Albedorox/smart-shisha-led/cad/v6/ansicht_schnitt_aussenring.png

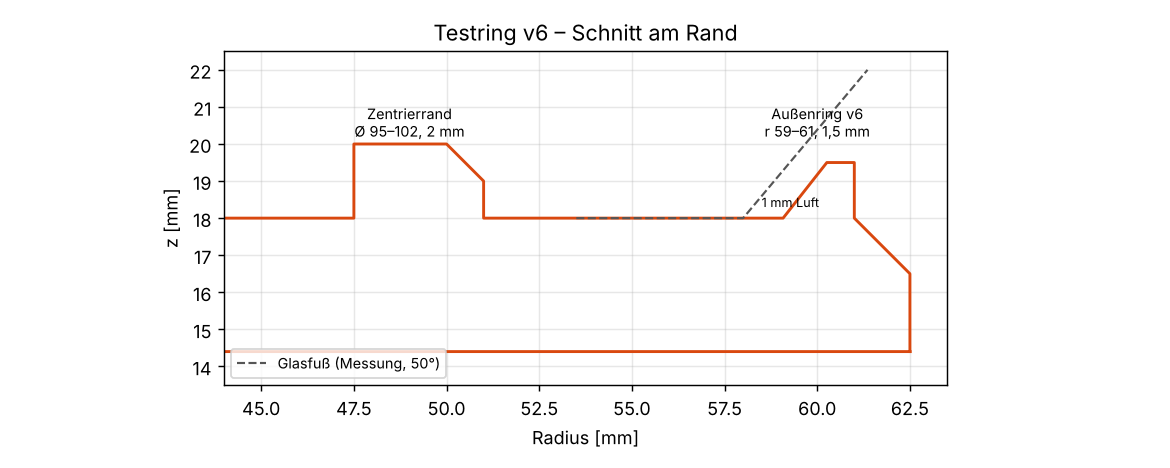
cad/v6/ansicht_schnitt_aussenring.png
