Albedorox/smart-shisha-led/docs/planung/fotos/01_sw420_oben.png

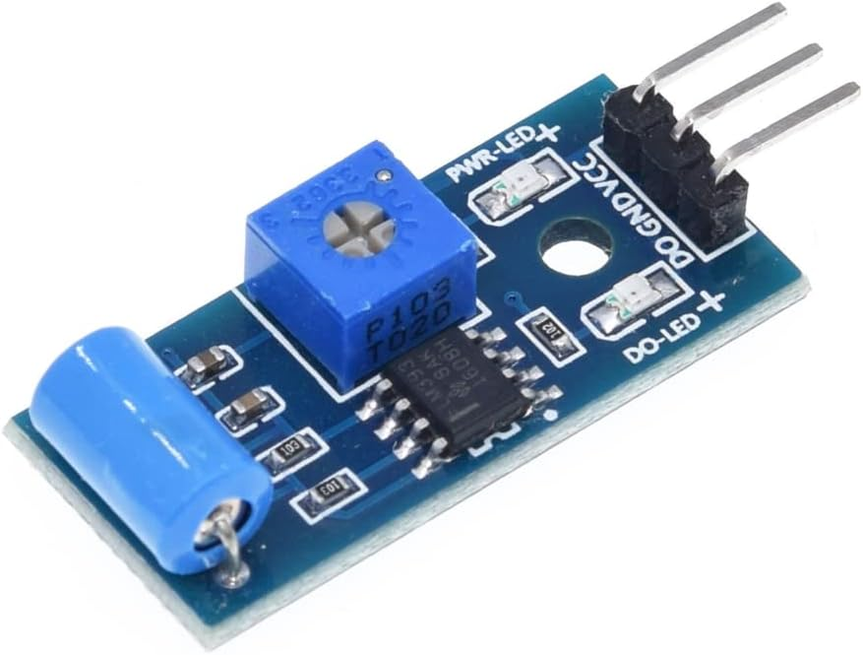
docs/planung/fotos/01_sw420_oben.png
