Albedorox/smart-shisha-led/docs/planung/fotos/02_supermini_pinout.png

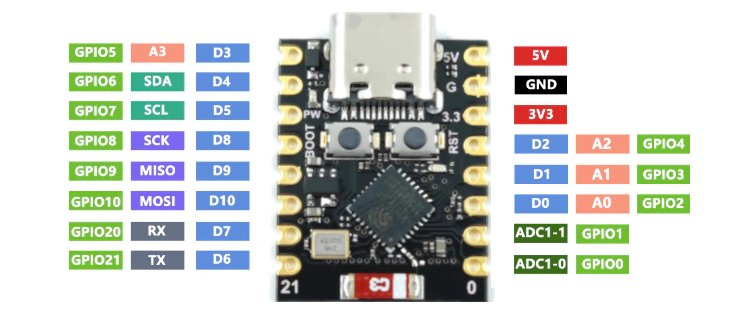
docs/planung/fotos/02_supermini_pinout.png
