Albedorox/smart-shisha-led/docs/planung/fotos/03_sw420_masse.png

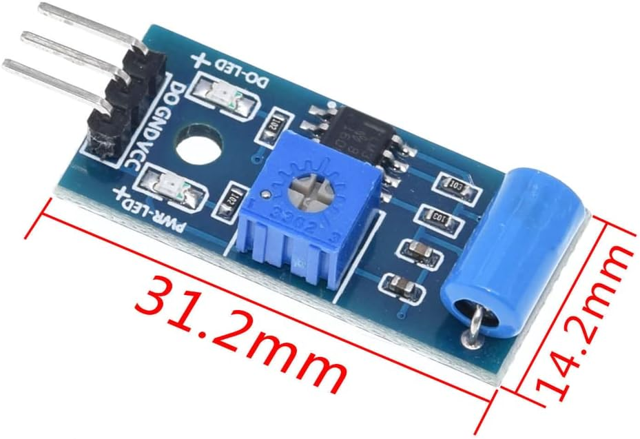
docs/planung/fotos/03_sw420_masse.png
