Albedorox/smart-shisha-led/docs/planung/fotos/04_ledring_rueckseite_masse.png

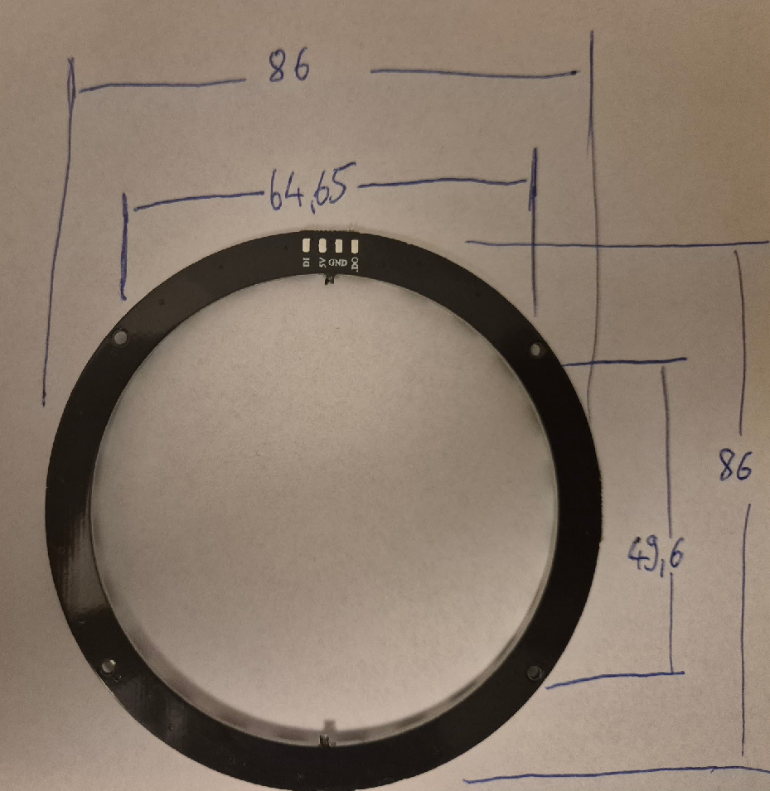
docs/planung/fotos/04_ledring_rueckseite_masse.png
