Albedorox/smart-shisha-led/docs/planung/fotos/05_ledring_vorderseite_masse.png

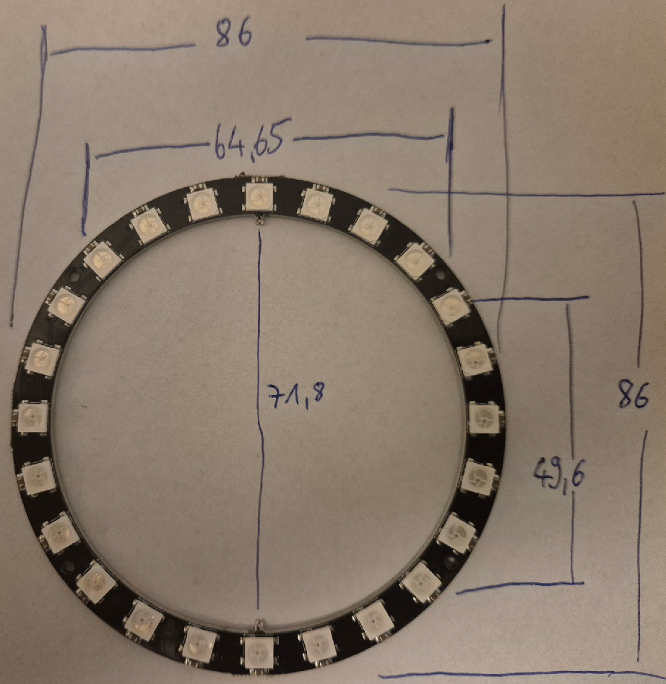
docs/planung/fotos/05_ledring_vorderseite_masse.png
