Albedorox/smart-shisha-led/docs/planung/fotos/06_glas_mit_ring_seite.png

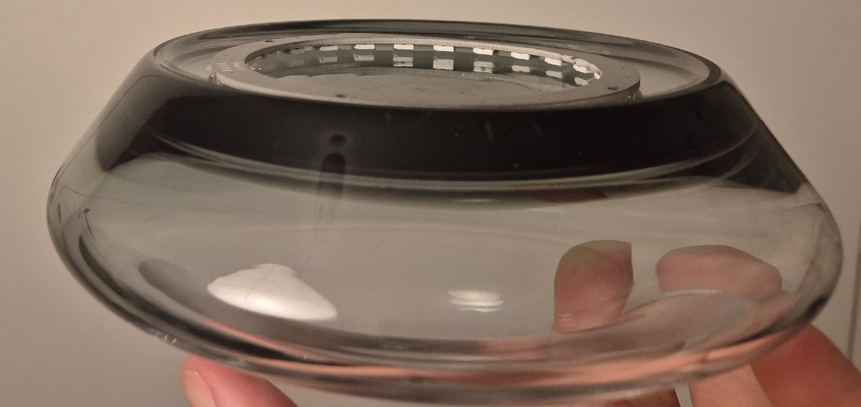
docs/planung/fotos/06_glas_mit_ring_seite.png
