Albedorox/smart-shisha-led/docs/planung/fotos/07_glas_seite.png

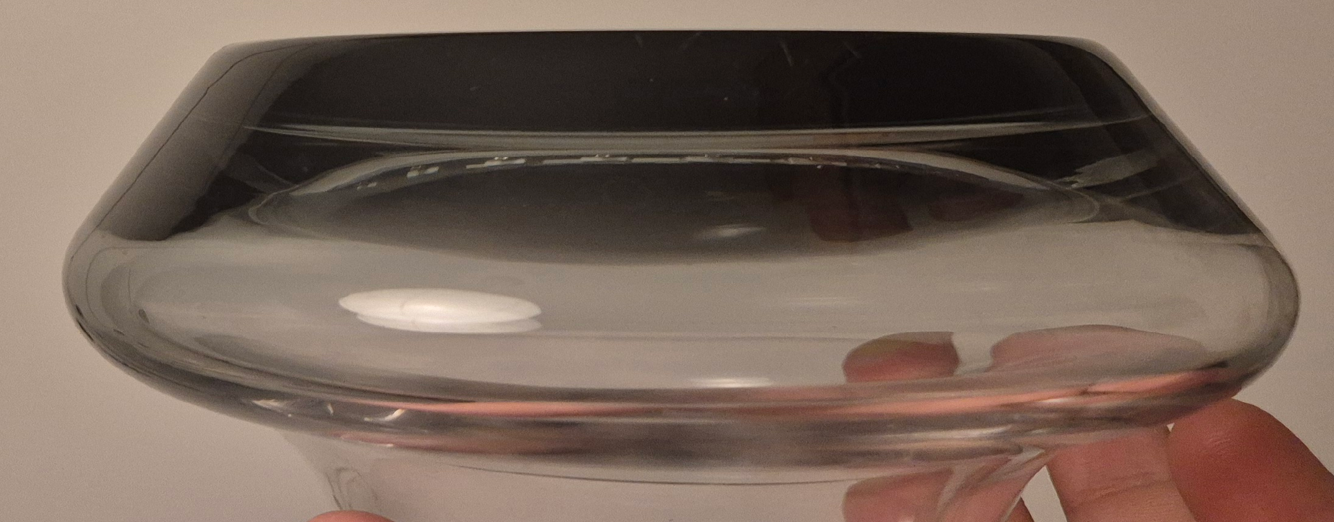
docs/planung/fotos/07_glas_seite.png
