Albedorox/smart-shisha-led/docs/planung/fotos/08_glas_mit_ring_unten.png

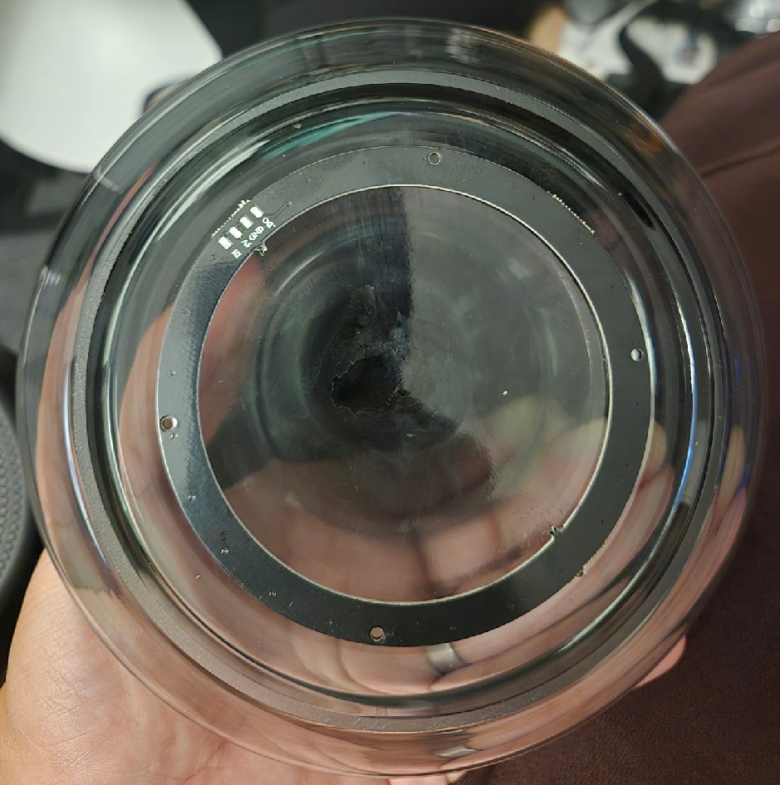
docs/planung/fotos/08_glas_mit_ring_unten.png
