Albedorox/smart-shisha-led/cad/v6/stl/P_Testring_v6.stl

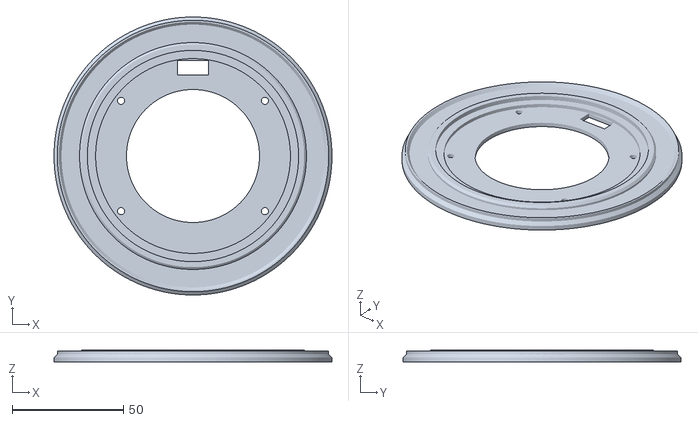
[picture p10: CAD file, 2026-10-28]
cad/v6/stl/P_Testring_v6.stl
125.0 x 125.0 x 5.60
