Albedorox/smart-shisha-led/cad/v6/stl/T1_Deckplatte_v6.stl

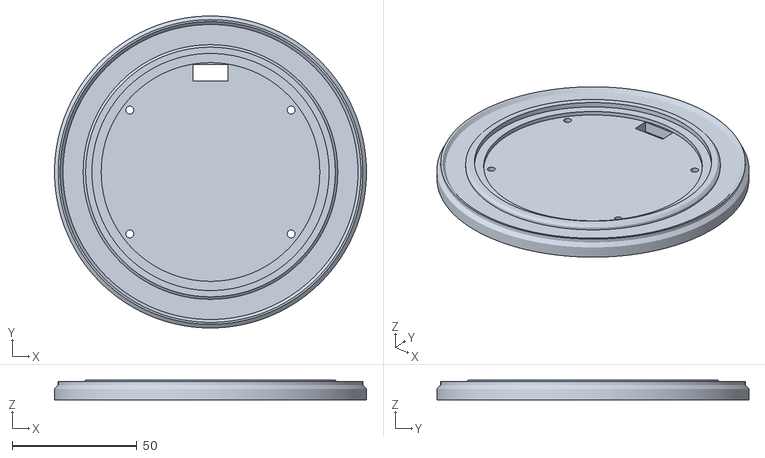
[picture p11: CAD file, 2026-10-28]
cad/v6/stl/T1_Deckplatte_v6.stl
125.0 x 125.0 x 8.00
