Albedorox/smart-shisha-led/cad/v2/stl/T1_Deckplatte_v2.stl

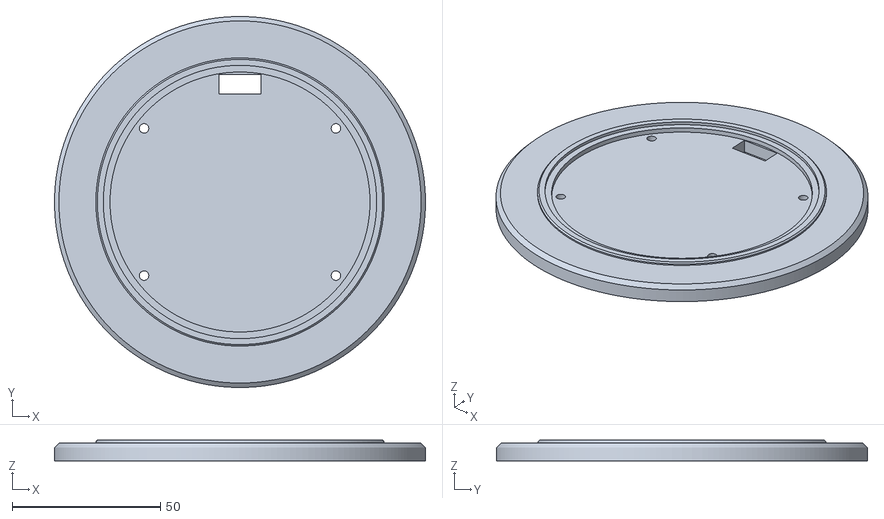
[picture p13: CAD file, 2026-10-24, an earlier design]
cad/v2/stl/T1_Deckplatte_v2.stl
125.0 x 125.0 x 7.00
