Albedorox/smart-shisha-led/cad/v4/stl/P_Testring_v4.stl

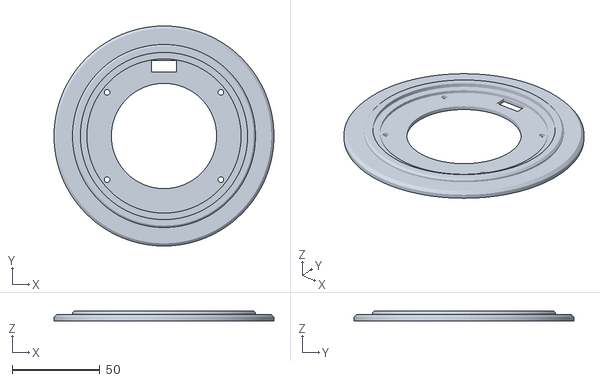
[picture p15: CAD file, 2026-10-28, an earlier design]
cad/v4/stl/P_Testring_v4.stl
125.0 x 125.0 x 5.60
