Albedorox/smart-shisha-led/cad/v1/stl/T1_Deckplatte_v1.stl

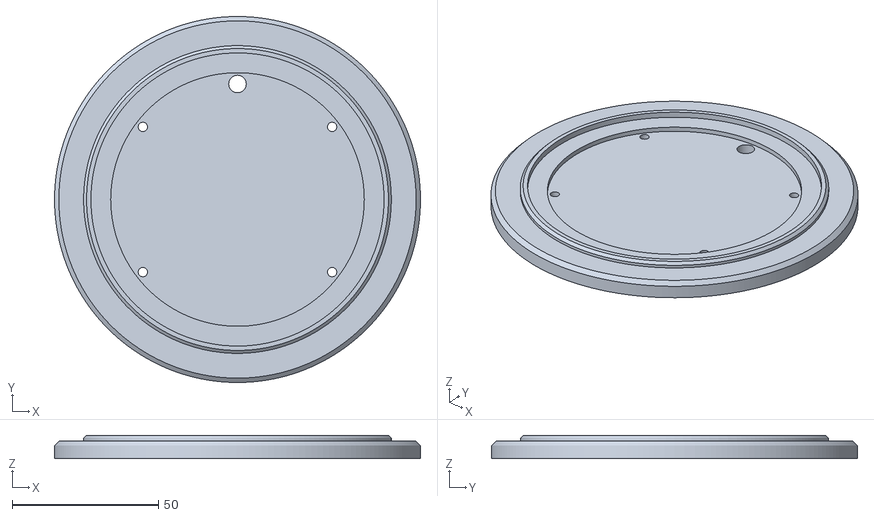
[picture p16: CAD file, 2026-10-24, an earlier design]
cad/v1/stl/T1_Deckplatte_v1.stl
125.0 x 125.0 x 8.00
