Albedorox/smart-shisha-led/cad/v1/stl/T4_Distanzring_v1.stl

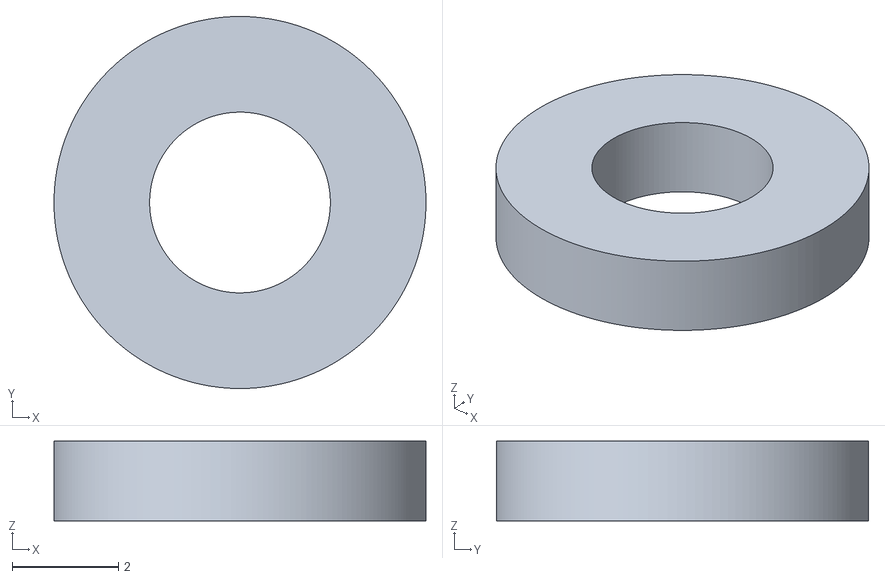
[picture p18: CAD file, 2026-10-24, an earlier design]
cad/v1/stl/T4_Distanzring_v1.stl
7.00 x 7.00 x 1.50
