Albedorox/smart-shisha-led/cad/v3/stl/T1_Deckplatte_v3.stl

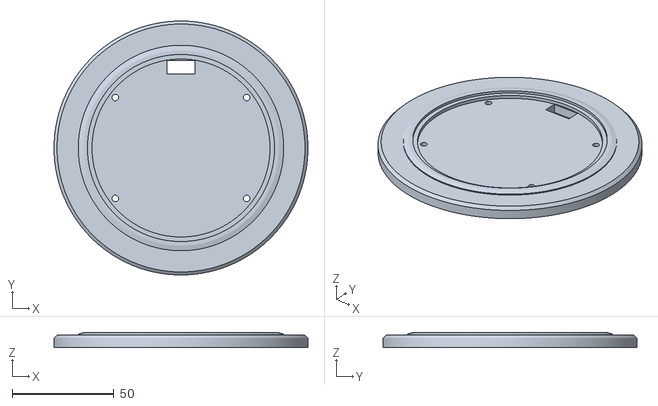
[picture p19: CAD file, 2026-10-25, an earlier design]
cad/v3/stl/T1_Deckplatte_v3.stl
125.0 x 125.0 x 7.20
