Albedorox/smart-shisha-led/cad/v1/stl/P_Coupon_v1.stl

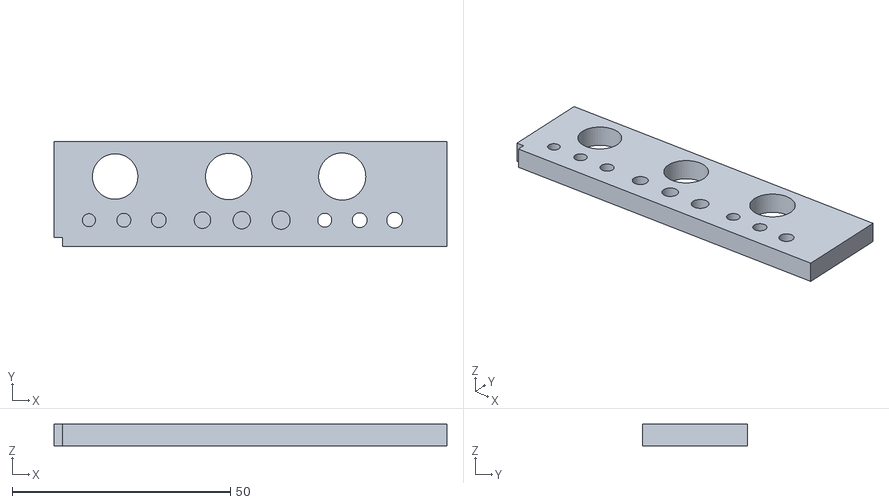
[picture p20: CAD file, 2026-10-24, an earlier design]
cad/v1/stl/P_Coupon_v1.stl
90.0 x 24.0 x 5.00
