Albedorox/smart-shisha-led/cad/v1/stl/P_Coupon_Stift_v1.stl

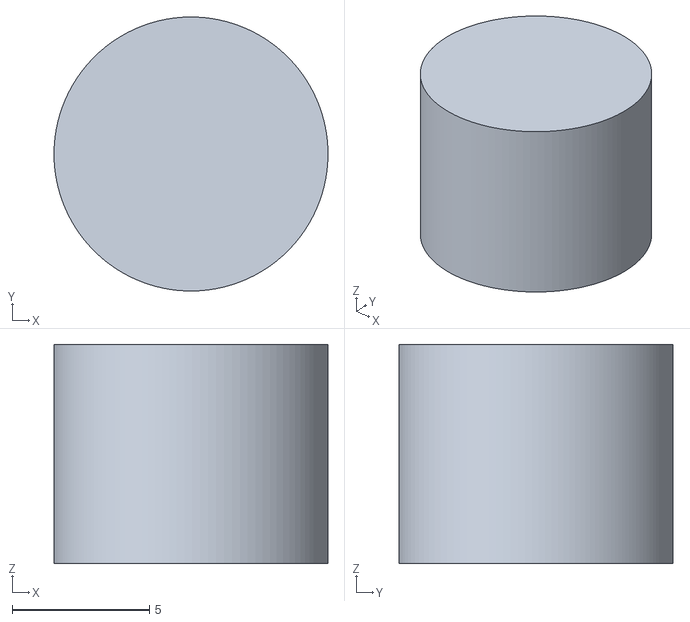
[picture p21: CAD file, 2026-10-24, an earlier design]
cad/v1/stl/P_Coupon_Stift_v1.stl
10.00 x 10.00 x 8.00
