Albedorox/smart-shisha-led/(list of files, cad)

Other CAD files:
cad/v5/stl/P_Testring_v5.stl
cad/v3/stl/T2_Unterschale_v3.stl
cad/v1/stl/P_Testring_v1.stl
