Albedorox/smart-shisha-led/ShishaLed/web_page.h

// Automatisch erzeugt aus web/index.html durch tools/gen_web_page.py – nicht von Hand ändern.
// Quelle 60864 Byte, gzip 18419 Byte.
#pragma once

#include <pgmspace.h>
#include <stddef.h>
#include <stdint.h>

static const char WEB_PAGE_ETAG[] = "\"4db9ff66424e8ba5\"";
static const size_t WEB_PAGE_GZ_LEN = 18419;
static const uint8_t WEB_PAGE_GZ[] PROGMEM = {
  0x1f,0x8b,0x08,0x00,0x00,0x00,0x00,0x00,0x02,0xff,0xed,0x7d,0x4d,0x73,0x1b,0x47,
  0x96,0xe0,0x5d,0xbf,0x22,0x55,0x52,0x77,0x00,0x16,0x00,0x02,0x20,0x41,0x49,0x00,
  0x49,0x0f,0x29,0x89,0xb6,0xc7,0x92,0xac,0x10,0xd5,0xb6,0xdb,0x6a,0xcd,0xa8,0x00,
  0x24,0x80,0x32,0x0b,0x55,0xe8,0xaa,0x02,0x29,0x8a,0x83,0x08,0x1f,0x36,0xf6,0x38,
  0x87,0x9d,0x8d,0x89,0x3d,0x74,0xcc,0xec,0xc1,0xb1,0x3f,0xa1,0x37,0x76,0xa3,0x4f,
  0xab,0x7f,0xe2,0x5f,0xb2,0xef,0x23,0x33,0x2b,0xb3,0xaa,0x00,0x81,0xb2,0x27,0x62,
  0x0f,0x3b,0x3d,0x16,0x51,0x55,0xf9,0xf9,0xf2,0x7d,0xe7,0xcb,0x97,0x07,0xb7,0xc7,
  0xf1,0x28,0xbb,0x5a,0x48,0x31,0xcb,0xe6,0xe1,0xd1,0xad,0x03,0xfc,0x23,0x42,0x3f,
  0x9a,0x1e,0x7a,0x63,0xe9,0xe1,0x0b,0xe9,0x8f,0xe1,0xcf,0x5c,0x66,0xbe,0x18,0xcd,
  0xfc,0x24,0x95,0xd9,0xa1,0xb7,0xcc,0x26,0xcd,0x07,0x9e,0x7e,0x1d,0xf9,0x73,0x79,
  0xe8,0x5d,0x04,0xf2,0x72,0x11,0x27,0x99,0x27,0x46,0x71,0x94,0xc9,0x08,0x8a,0x5d,
  0x06,0xe3,0x6c,0x76,0x38,0x96,0x17,0xc1,0x48,0x36,0xe9,0xa1,0x11,0x44,0x41,0x16,
  0xf8,0x61,0x33,0x1d,0xf9,0xa1,0x3c,0xec,0x34,0x74,0xad,0xe6,0x24,0xc8,0x0e,0x47,
  0xf1,0x85,0x4c,0x0a,0xcd,0x8e,0xe2,0x30,0x4e,0xa0,0xf8,0x4c,0xce,0xa5,0xd5,0xf4,
  0xd8,0x4f,0xce,0xb1,0x64,0x16,0x64,0xa1,0x3c,0x3a,0x9b,0x05,0xe9,0xcc,0x17,0x4f,
  0x9f,0x3c,0x3e,0xd8,0xe1,0x37,0xb7,0x0e,0xd2,0xec,0x0a,0xff,0xf6,0x93,0x38,0xce,
  0xae,0x9b,0xcd,0xe1,0xb4,0x7f,0xa7,0xfd,0xa4,0xd3,0xee,0x74,0x07,0xcd,0x66,0xba,
  0x4c,0x26,0xfe,0x48,0xf6,0xef,0x74,0x1e,0x74,0x4e,0x3a,0xa7,0xf9,0x9b,0x66,0xb7,
  0x7f,0xa7,0xdb,0xed,0xee,0x77,0x4f,0xe0,0x5d,0x18,0x44,0x50,0xa4,0xfb,0x64,0x77,
  0x77,0xf7,0x18,0x1e,0x33,0xf9,0x2e,0xeb,0xdf,0x79,0xf2,0xe8,0xc9,0xe9,0xe9,0x2e,
  0x3c,0xce,0x97,0x99,0x1c,0xf7,0xef,0x3c,0x3c,0x3e,0xde,0x3d,0x7e,0x0c,0xcf,0xfe,
  0x68,0x04,0x23,0xeb,0xdf,0xd9,0x3b,0x7d,0xb4,0x7b,0x7a,0x1f,0x5e,0x4c,0x13,0x29,
  0xa3,0xfe,0x9d,0xdd,0xc7,0x8f,0x1f,0x3d,0xd8,0x83,0xe7,0x2b,0x19,0x86,0xf1,0x65,
  0xff,0xce,0xe9,0xe9,0xe3,0xde,0x1e,0xf6,0x99,0x60,0xfd,0xd3,0xd3,0x5e,0xb7,0x87,
  0x63,0x1a,0x03,0xd0,0x65,0x62,0xbd,0x48,0xfa,0x9d,0xee,0xe2,0x1d,0xfc,0x88,0xfc,
  0x8b,0xe6,0xac,0xbf,0xbf,0x47,0x0f,0xa9,0x3f,0x91,0xcd,0x61,0x5f,0x46,0x17,0x35,
  0xfa,0xe9,0x27,0xd2,0x6f,0x06,0x11,0x2c,0x4b,0x73,0x18,0x67,0x59,0x3c,0x6f,0xb4,
  0x17,0xef,0xea,0xab,0x5b,0x9f,0x5d,0x0f,0xe3,0x77,0xcd,0x34,0x78,0x1f,0x44,0xd3,
  0xfe,0x30,0x4e,0xc6,0x32,0x81,0x02,0xef,0x56,0xb7,0x70,0x85,0xaf,0x9b,0x97,0x72,
  0x78,0x1e,0x64,0x34,0x27,0x2c,0x04,0xed,0x8c,0x7f,0x5c,0xa6,0x59,0xbf,0xd3,0x6e,
  0xff,0x6e,0x75,0x6b,0x18,0x8f,0xaf,0xae,0xe7,0x7e,0x32,0x0d,0xa2,0x7e,0x7b,0x30,
  0xf4,0x47,0xe7,0xd3,0x24,0x5e,0x46,0xe3,0xfe,0x85,0x9f,0xd4,0x10,0x96,0xf5,0x01,
  0xad,0x8b,0x7a,0xc6,0x56,0xea,0x83,0x09,0xac,0x4d,0xbf,0x93,0xc8,0xf9,0x4e,0xa7,
  0xb5,0xd7,0x13,0xe9,0x55,0x9a,0xc9,0x79,0x73,0x19,0x34,0x9a,0xfe,0x62,0x11,0xca,
  0x26,0xbf,0x68,0x78,0x67,0x72,0x1a,0x4b,0xf1,0x87,0xaf,0xbc,0xc6,0xcb,0x18,0x86,
  0x1c,0x37,0x52,0x3f,0x4a,0x9b,0xa9,0x4c,0x82,0xc9,0x00,0x11,0x60,0x02,0x50,0x6a,
  0xbe,0xeb,0xcf,0x82,0xf1,0x58,0x46,0x30,0x96,0x25,0xcc,0x2a,0x02,0xc4,0x59,0x2c,
  0xb3,0x46,0x2a,0x43,0x39,0xca,0xae,0xa9,0xab,0x20,0x9a,0x41,0x9d,0x4c,0x8d,0x44,
  0x3d,0xad,0x6e,0xf9,0xd7,0xf6,0xd0,0x78,0x55,0x00,0x1e,0xb3,0x2e,0xd5,0xa2,0xc9,
  0xf6,0x5b,0x0f,0x60,0x98,0x34,0x60,0x00,0x44,0x30,0x9d,0x65,0xfd,0xfd,0x76,0x7b,
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
};
