Albedorox/smart-shisha-led/(commit log)

2026-10-24 Planungsdokumente Phase A (Rev. 2) und README
    Claude-Session: https://claude.ai/code/session_012fnGRuBGB34RLnBmSj7RU1
2026-10-24 CAD-Entwurf v1: Deckplatte und Unterschale (vor G3)
    Parametrisches SolidCraft-Modell mit Parameterliste, Zeitleisten-Skript
    und Ansichten. Noch keine Druckdateien. 08_cad_mcp_plan.md um die
    Ergebnisse der Funktionstests ergänzt.
    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
    [parameter.csv]
2026-10-24 B0: Testsketches für Sensor, LED-Ring und Zug+Licht
    Wegwerfsketches für die Hardware-Verifikation (Sensorpolarität,
    Impulsbreiten, Zugerkennung am Glas, LED-Reihenfolge, Lichtwirkung,
    Strommessung) mit Anleitung und Messprotokoll.
    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
2026-10-24 cad/README: Druckrichtung T1 korrigiert (Glasauflage nach oben)
    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
2026-10-24 CAD: Zentrier-Testring und Toleranzcoupon als STL (nach G3)
    Testteile aus dem Modell abgeleitet und exportiert, Netzprüfung
    bestanden. README um Prüfanleitung ergänzt.
    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
    [P_Coupon_Stift_v1.stl, P_Coupon_v1.stl, P_Testring_v1.stl]
2026-10-24 B1: Firmware-Kernlogik mit Host-Tests
    Konfiguration (Validierung alles-oder-nichts, Reset-Bereiche, idleGlow),
    Zug-Zustandsmaschine mit Diagnose, Rangliste und Spielername (UTF-8),
    LED-Logik (Verlauf, Fade-out, Stromgrenze, Bereitschaftsglimmen).
    43 Host-Tests (T-FW-02…19, -22) mit ASan/UBSan, CI-Workflow.
    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
    [ShishaLed.ino, app_config.h, color_math.cpp, color_math.h, config_manager.cpp, config_manager.h, led_logic.cpp, led_logic.h]
2026-10-24 CAD: Vollteile T1/T2/T4 mit Elektronikhalterungen als STL
    SuperMini-Rahmen mit Programmieröffnung, Halter für USB-C-Breakout
    (rotes Modul, Buchse in der Wand), Verdrehsicherung und Distanzring
    für den Sensor. Passungen noch mit Startwerten (Coupon ausstehend).
    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
    [T1_Deckplatte_v1.stl, T2_Unterschale_v1.stl, T4_Distanzring_v1.stl, parameter.csv]
2026-10-24 CAD v2: Glasauflage, Ringeinfassung und Lötpad-Aussparung nach Testdruck 1
    - Zentrierrand 4 mm weiter innen und 1 mm statt 2 mm hoch (Glas kippelte)
    - Einfassung LED-Ring +1 mm im Durchmesser (Ring passte nur knapp)
    - Kabelloch Ø6 durch rechteckige Aussparung 14 x 6,6 mm unter den Pads ersetzt
    - Glas-Hüllkörper als Kugelkappe genähert, passt zum gemessenen Anheben
    - Export P_Testring_v2 und T1_Deckplatte_v2; T2/T4 unverändert v1
    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
    [P_Testring_v2.stl, T1_Deckplatte_v2.stl, parameter.csv]
2026-10-24 CAD v2: Gleitpassung 0,2 mm nach Toleranzcoupon
    Stift Ø10 passt am besten in Ø10,4, M3-Schraube in Ø3,4. Einschmelzmuttern
    noch ungetestet, mittlere Bohrung angenommen (Werte unverändert).
    T1 v2 neu exportiert; T2 unverändert.
    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
    [P_Testring_v2.stl, T1_Deckplatte_v2.stl, parameter.csv]
2026-10-24 Rohfassung: Firmware mit Hardware, Web-App und Bauanleitung
    - ShishaLed.ino verbindet die Kernlogik mit SW-420 (ISR-Latch), LED-Ring
    (Adafruit NeoPixel), offenem WLAN "ShishaLed" mit Web-App und HTTP-API
    (/api/state, /api/config, /api/name, /api/reset) und Preferences
    - web_page.h: Web-App als eine Seite ohne externe Dateien
    - docs/anleitung_rohfassung.md: Druck, Verdrahtung, Montage, Flashen,
    Bedienung und die gesetzten Annahmen
    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
    [ShishaLed.ino, app_config.h, web_page.h]
2026-10-25 Firmware automatisch bauen und im Browser flashen
    - Workflow "Firmware": baut ShishaLed mit arduino-cli für den ESP32-C3
    (USB CDC On Boot), erzeugt eine Flash-Datei ShishaLed-merged.bin und
    veröffentlicht sie auf main als Release "firmware-latest"
    - docs/flashen.md: Flashen mit dem Web-Flasher von Espressif an 0x0
    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
2026-10-25 Web-App mit 8 Screens und API nach Spezifikation 06
    - web/index.html: Start, Licht, Spieler, Rangliste, Farbverlauf, Sensor,
    System, Hilfe (Hash-Routing, Tab-Leiste + „Mehr“, Seitenleiste ab 900 px);
    kein horizontaler Überlauf bei 360 px
    - tools/gen_web_page.py erzeugt ShishaLed/web_page.h (gzip + ETag), CI prüft
    - web_api.cpp: /api/status, /api/leaderboard, /api/config, /api/name,
    /api/leaderboard/reset mit Fehlerformat nach 06 (ArduinoJson 7)
    - ShishaLed.ino ohne Preferences: keine Speicherung (SYS-03)
    - WLAN-Name bleibt „ShishaLed“, Firmware 0.3.0
    Claude-Session: https://claude.ai/code/session_012fnGRuBGB34RLnBmSj7RU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
    [ShishaLed.ino, app_config.h, gen_web_page.py, session_manager.h, web_api.cpp, web_api.h, web_page.h]
2026-10-25 CI-Prüfung der Web-Seite vergleicht entpackten Inhalt statt gzip-Bytes
    Die gzip-Ausgabe hängt von der zlib-Version ab; auf dem CI-Runner
    unterschied sie sich trotz gleicher Quelle.
    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
2026-10-25 CAD v3: Zentrierrand, Nut, Sensorstifte, SuperMini-Halter nach Vollteil-Druck
    - Zentrierrand Ø101,1, innen 1,2 mm, außen schräg auf 0,5 mm (folgt Glaswölbung)
    - Nut T1: 0,3 mm Spiel, 45°-Dach ohne Support, Einführfasen; Feder T2 angefast
    - Sensorstifte mit Stützrippen (außen bis zur Wand)
    - SuperMini: Rahmen bis Platinenoberkante, Schnappzunge an der Antennenseite
    - STL T1/T2/Testring v3, Schnitt- und Detailansichten, Anleitung angepasst
    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
    [P_Testring_v3.stl, T1_Deckplatte_v3.stl, T2_Unterschale_v3.stl, parameter.csv]
2026-10-27 CAD v4: Testring mit höherem Zentrierrand weiter außen
    Rand Ø106,1 außen, 2 mm hoch, 45°-Fase (wie v1, 0,5 mm weiter außen).
    Nur der Testring ist exportiert; T1/T2 bleiben v3 bis zur Rückmeldung.
    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
    [P_Testring_v4.stl]
2026-10-27 CAD v4: Testring mit Innendurchmesser 95 mm
    Der Rand ist wieder 4,5 mm breit wie bei v3 und als Ganzes nach außen
    versetzt: r 47,5–52 (Innen-Ø 95, Außen-Ø 104), 2 mm hoch, 45°-Fase 1 mm.
    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
    [P_Testring_v4.stl]
2026-10-28 CAD v5: Testring mit Außen-Ø 102 mm
    Der Zentrierrand ist außen 1 mm schmaler als bei v4: r 47,5–51,
    2 mm hoch, 45°-Fase 1 mm. Die STL ist aus der v4-Datei abgeleitet,
    das SolidCraft-Modell folgt.
    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
    [P_Testring_v5.stl]
2026-10-28 CAD v6: Testring mit niedrigem Außenring
    Außenring r 59–61, 1,5 mm hoch, Innenseite 50° parallel zum Glas mit
    ca. 1 mm Luft. Basis ist v5.
    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
    [P_Testring_v6.stl]
2026-10-28 CAD v6: T1 mit geprüfter Glashalterung
    T1 v3 bekommt Zentrierrand (Ø 95–102, 2 mm) und Außenring (r 59–61,
    1,5 mm, Innenseite 50°) aus dem Testring v6. Unterhalb z 17,9 ist T1
    identisch mit v3. Druckliste in der Anleitung zeigt auf T1 v6.
    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
    [T1_Deckplatte_v6.stl]
2026-10-28 CAD v6: SolidCraft-Modell mit Glashalterung
    Zentrierrand (center_clear 2,55, center_rim_w 3,5) und Außenring
    (oring_w, oring_h, oring_run) im Profil S_T1_Profil. Zeitleiste am Ende
    gespeichert. T1 und Testring stimmen mit den STLs in cad/v6/stl bis auf
    die Facettierung überein, T2 ist unverändert.
    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
2026-11-08 Doku: Verdrahtungsplan als SVG
    tools/gen_wiring_svg.py erzeugt docs/verdrahtung.svg mit Breakout,
    SuperMini, LED-Ring, SW-420 und Elko. Die Bauanleitung bindet den Plan
    in Abschnitt 3 ein.
    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
2026-11-08 Sensorpolarität: SW-420 aktiv bei HIGH
    Am echten Aufbau gemessen: in Ruhe LOW (DO-LED an), bei Vibration HIGH.
    Mit SENSOR_ACTIVE_LOW = true sah die Firmware in Ruhe einen Dauerzug.
    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
    [B0_ZugUndLicht.ino, app_config.h]
2026-11-14 Bauanleitung mit Bildern aus dem CAD
    docs/bauanleitung.md ersetzt die Rohfassung: Teile- und Schraubenliste,
    welche Einschmelzmutter wohin, Ring, Sensor, SuperMini und Breakout
    einbauen, Verdrahtung, Funktionstest, Schließen, Fehlersuche.
    Die Bilder erzeugt tools/gen_bauanleitung_bilder.py aus den STL-Dateien.
    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
2026-11-14 Bauanleitung: Übersicht, alle Befestigungen, Litzenliste, Detailbilder
    Vorne eine Übersicht mit nummeriertem Bild (Teil, Ort, Ausrichtung,
    Befestigung, Schritt) und eine Liste aller Schrauben und Muttern.
    Jeder Schritt nennt die benötigten Teile. Neu: Litzenliste R1-S3/P1-P2,
    Detailbilder T2-Plätze, SuperMini-Rahmen und Breakout.
    Korrektur: Breakout mit Blechschraube 2,5 x 4 statt 6 (Sockelloch nur
    2,7 mm tief, darunter 0,8 mm Boden). SuperMini-Lage im Bild korrigiert.
    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
    [gen_bauanleitung_bilder.py]
